falcon14141/Voron_Mods/README.md

# Voron_Mods
 Mods for my Voron 3D printers
