falcon14141/Voron_Mods/Lovely Frog Z Idler/mods/README.md

# User Mods for LFZI # 

| Mods | Authors | Description |
| ---- | --- | --- |
| [M3 screw Tensioner](./m3_screw_tensioner/) | @fboc#1751 | Replace M5 screw by M3 to reduce step per rotation, replace insert by M3 square nut. |
