falcon14141/Voron_Mods/3D Cable Chain/images/1.png

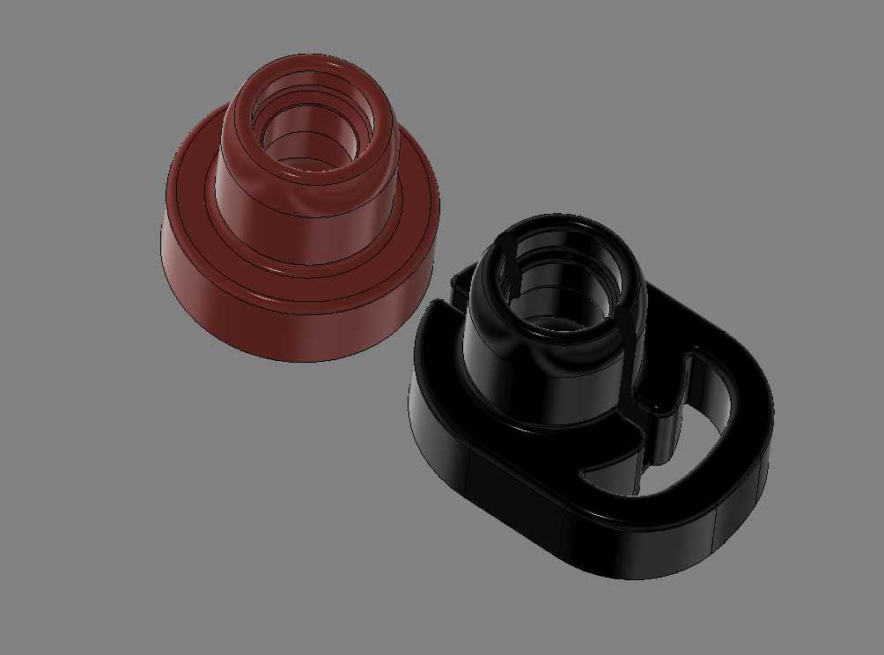
3D Cable Chain/images/1.png
