falcon14141/Voron_Mods/Dampened Fan Skirt/images/1.png

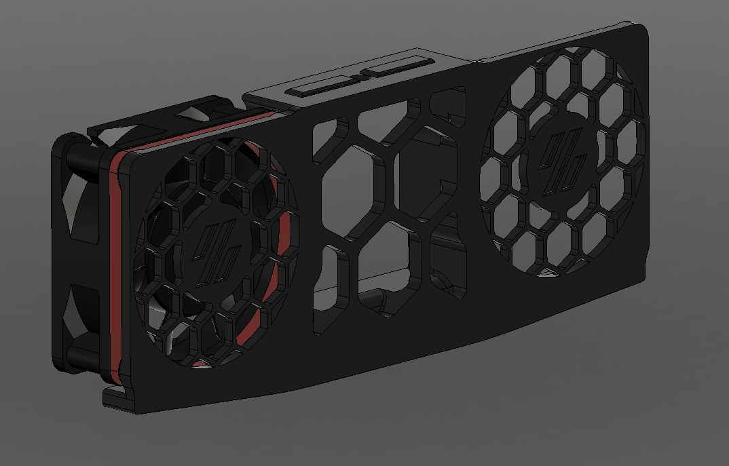
Dampened Fan Skirt/images/1.png
