falcon14141/Voron_Mods/Endstops/Y_opto_endstop/images/gantry_back.png

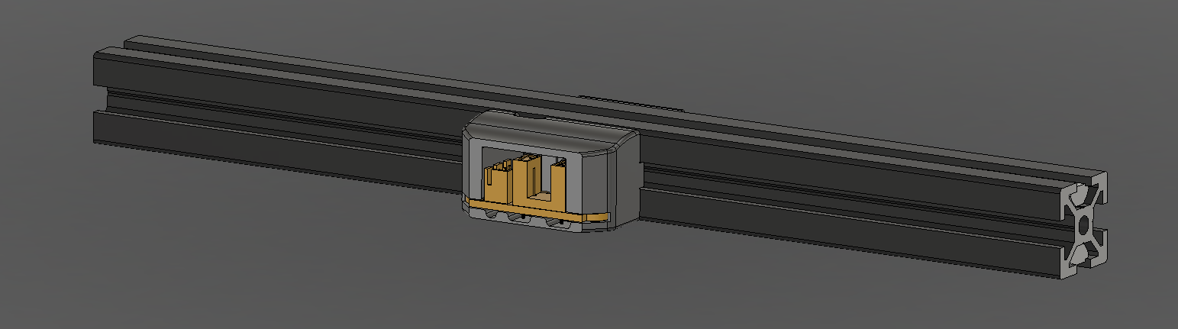
Endstops/Y_opto_endstop/images/gantry_back.png
