falcon14141/Voron_Mods/Endstops/Y_opto_endstop/images/x-axis.png

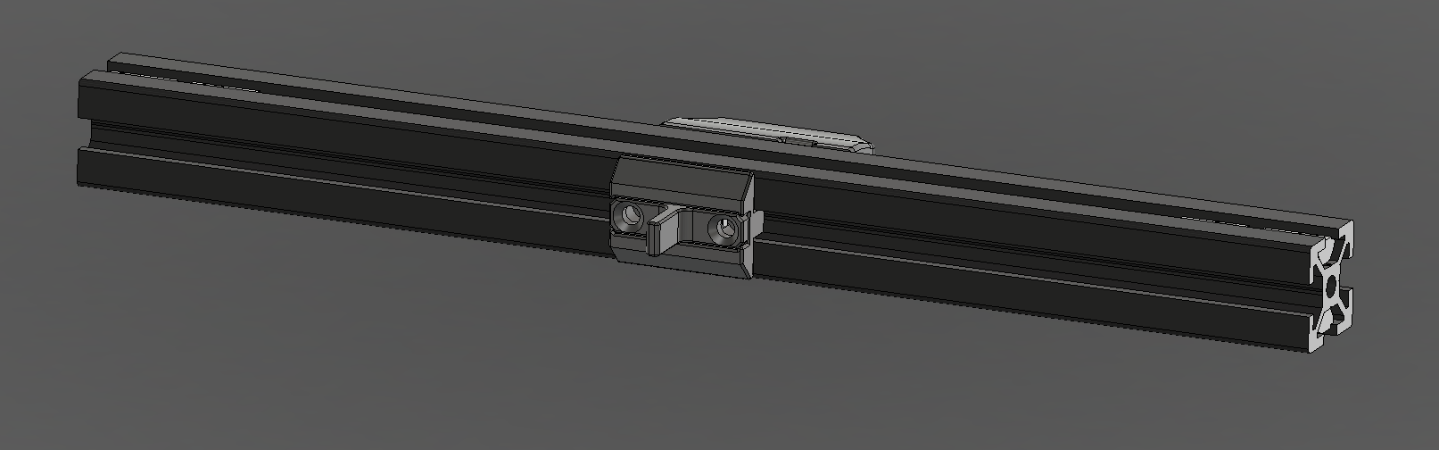
Endstops/Y_opto_endstop/images/x-axis.png
