falcon14141/Voron_Mods/Endstops/Z_Chainguard_YEndstop/images/1.png

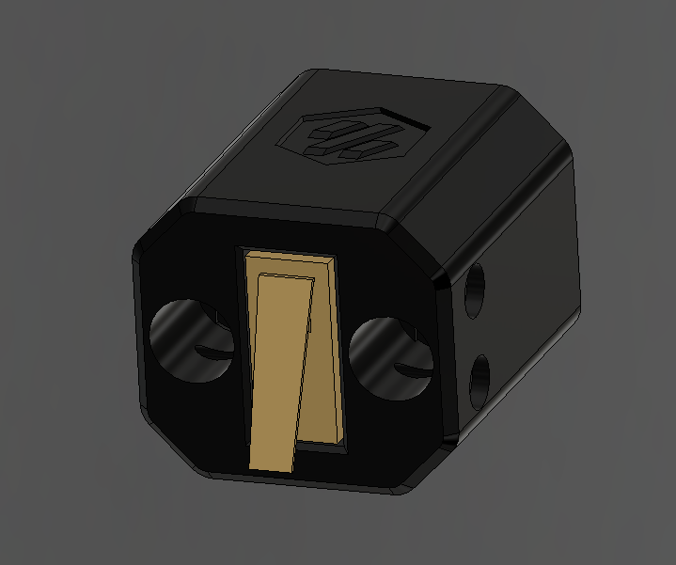
Endstops/Z_Chainguard_YEndstop/images/1.png
