falcon14141/Voron_Mods/Endstops/ZMagEndstop/images/1.png

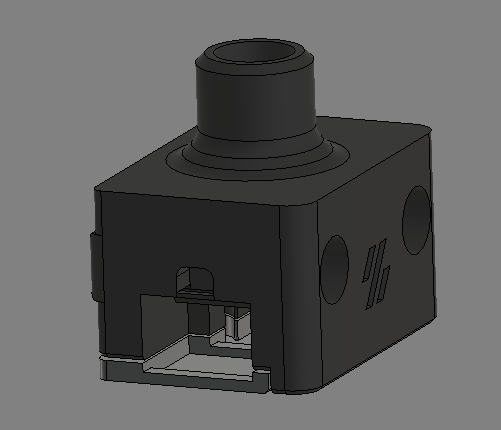
Endstops/ZMagEndstop/images/1.png
