falcon14141/Voron_Mods/Endstops/ZOptoEndstop/images/1.png

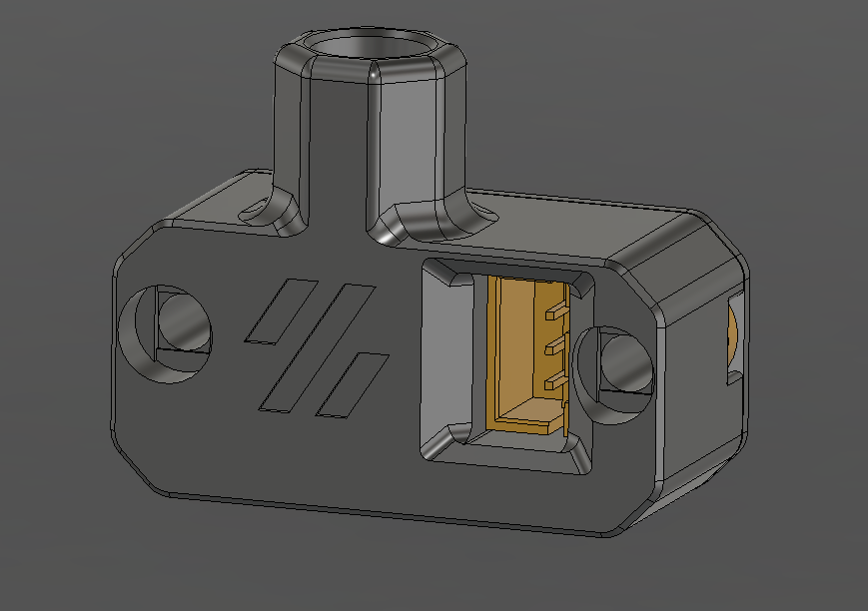
Endstops/ZOptoEndstop/images/1.png
