falcon14141/Voron_Mods/Horizontal Z chain (for CANboards)/images/1.png

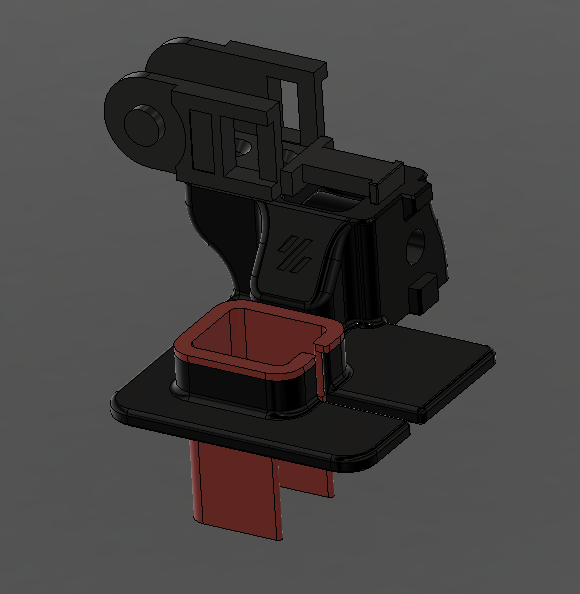
Horizontal Z chain (for CANboards)/images/1.png
