falcon14141/Voron_Mods/PiTFT 5.0 v2 hinged mount/images/2.png

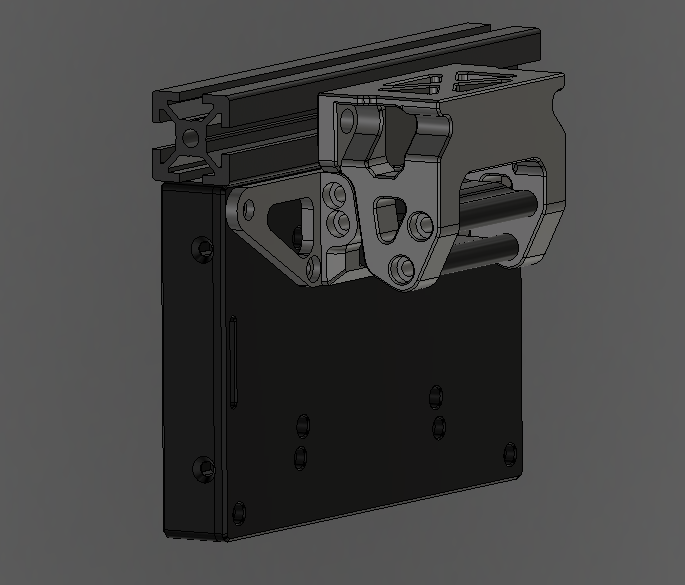
PiTFT 5.0 v2 hinged mount/images/2.png
