falcon14141/Voron_Mods/TAP Cheapzzlecam/images/CamModule.png

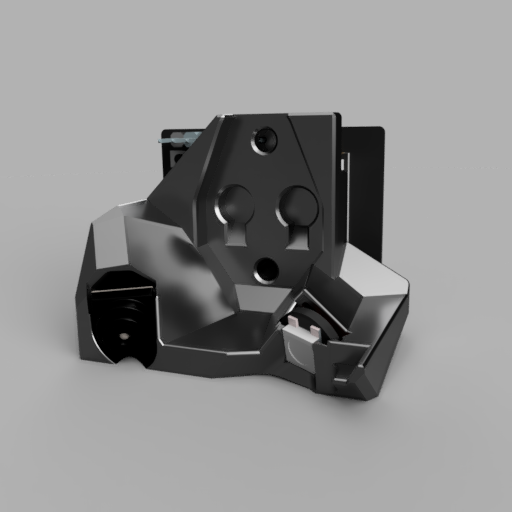
TAP Cheapzzlecam/images/CamModule.png
