falcon14141/Voron_Mods/TAP Cheapzzlecam/images/front.png

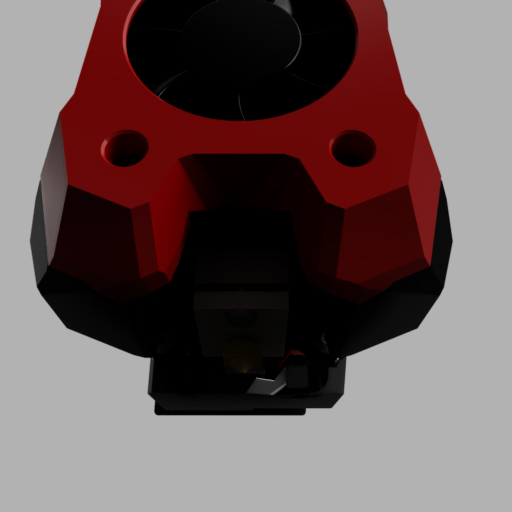
TAP Cheapzzlecam/images/front.png
