falcon14141/Voron_Mods/TAP Cheapzzlecam/images/side.png

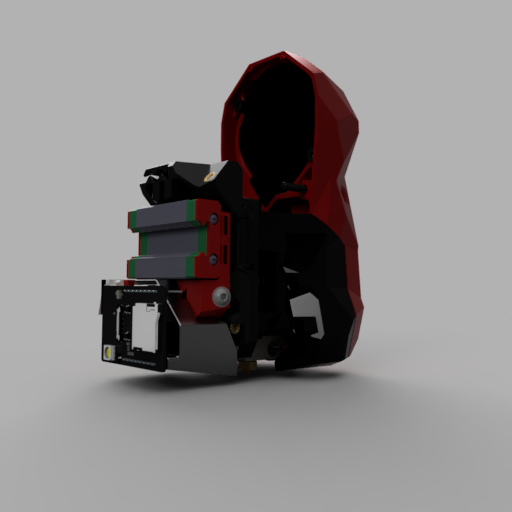
TAP Cheapzzlecam/images/side.png
