falcon14141/Voron_Mods/TAP Cheapzzlecam/images/Tap and mount.png

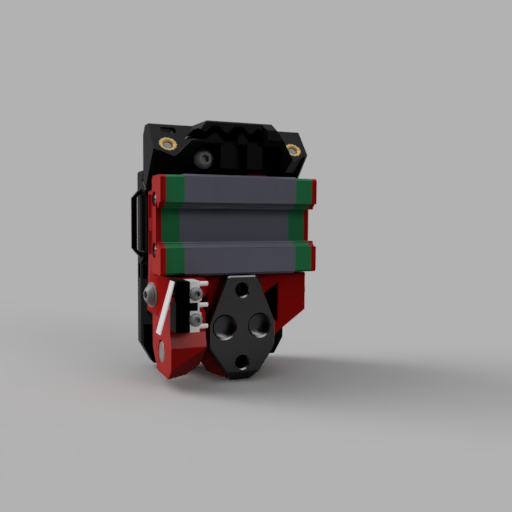
TAP Cheapzzlecam/images/Tap and mount.png
