falcon14141/Voron_Mods/3D Cable Chain/3mf/3DChain.3mf

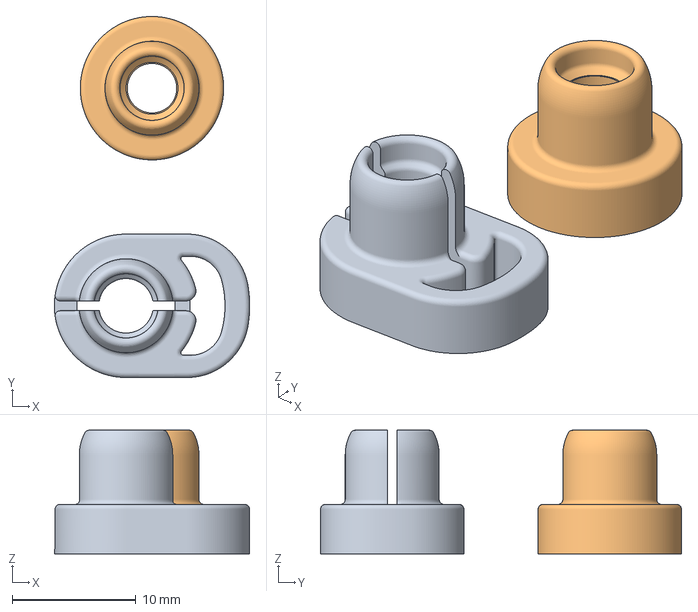
[picture p27: CAD file, 2022-07-03]
3D Cable Chain/3mf/3DChain.3mf
15.8 x 29.2 x 10.00 mm
Corps1
Corps6
