falcon14141/Voron_Mods/Dampened Fan Skirt/3mf_stl/Middle Fan Support.3mf

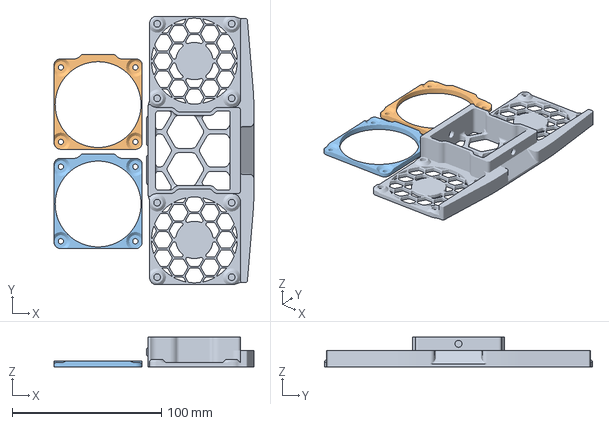
[picture p28: CAD file, 2022-07-03]
Dampened Fan Skirt/3mf_stl/Middle Fan Support.3mf
134.2 x 180.0 x 20.0 mm
side_fan_support_x2
spacer x 2
