falcon14141/Voron_Mods/Endstops/Y_opto_endstop/3mf/YOpticalEndstop.3mf

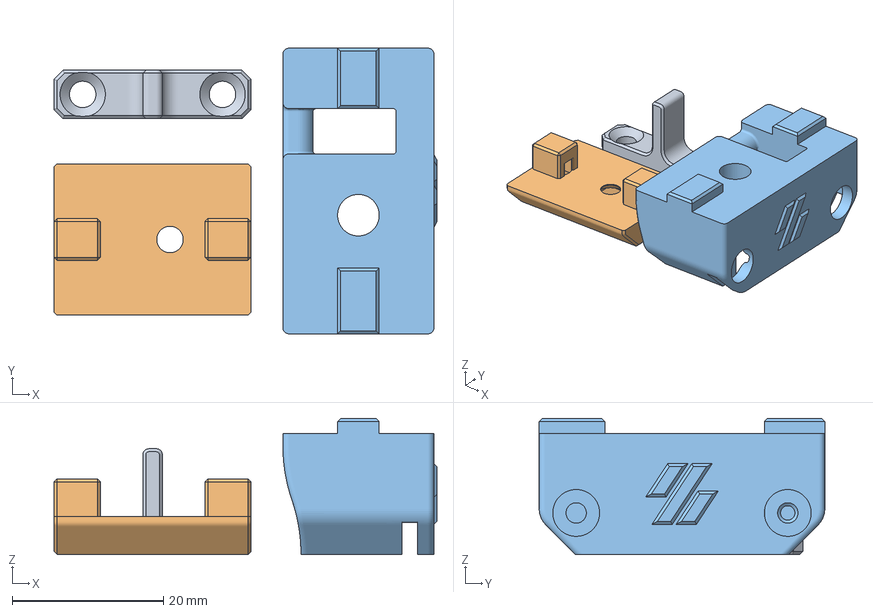
[picture p29: CAD file, 2022-07-03]
Endstops/Y_opto_endstop/3mf/YOpticalEndstop.3mf
50.7 x 37.8 x 18.0 mm
YFlag
YFlagMount
YOpticalEndstop
