falcon14141/Voron_Mods/Endstops/Z_Chainguard_YEndstop/3mf/YMechEndstopZChainGuard.3mf

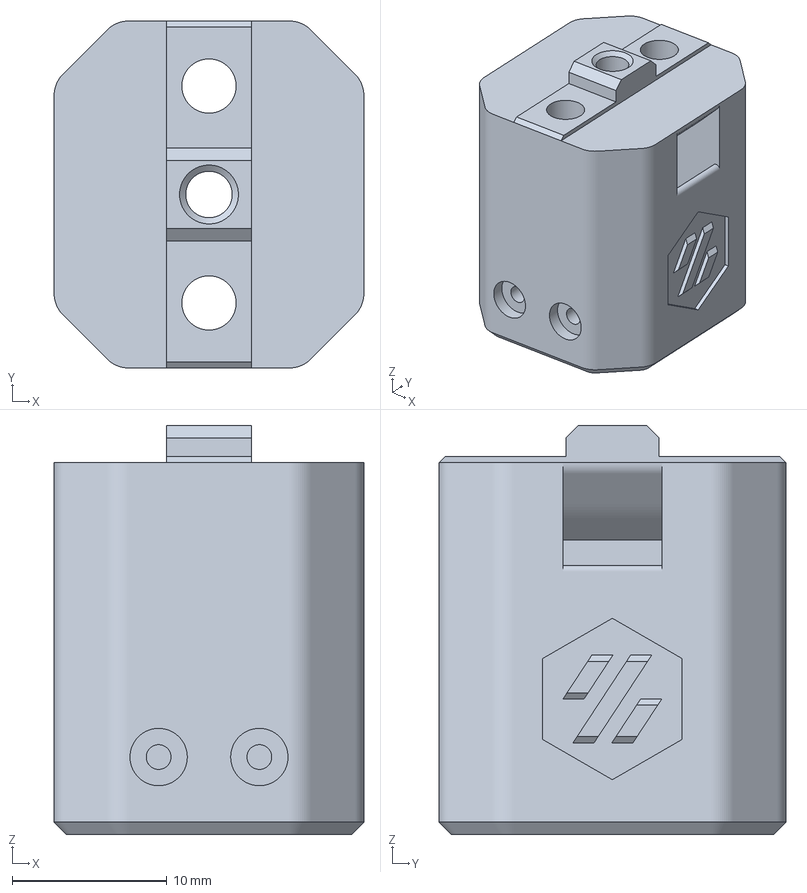
[picture p30: CAD file, 2022-07-03]
Endstops/Z_Chainguard_YEndstop/3mf/YMechEndstopZChainGuard.3mf
20.0 x 22.4 x 26.4 mm
