falcon14141/Voron_Mods/Endstops/ZMagEndstop/3mf/ZMagEndstop.3mf

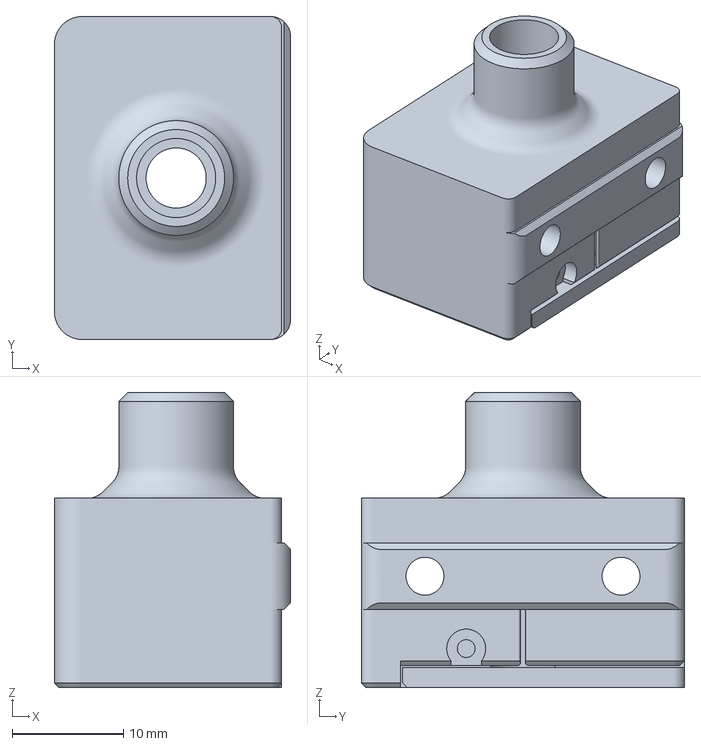
[picture p31: CAD file, 2022-07-17]
Endstops/ZMagEndstop/3mf/ZMagEndstop.3mf
21.2 x 29.0 x 26.5 mm
