falcon14141/Voron_Mods/Endstops/ZOptoEndstop/3mf/ZOpticalEndstop.3mf

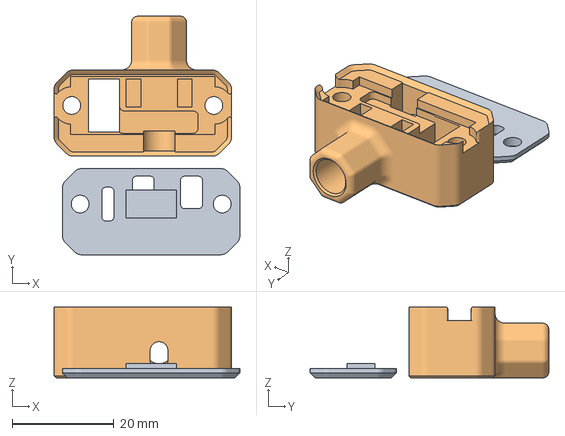
[picture p32: CAD file, 2022-07-03]
Endstops/ZOptoEndstop/3mf/ZOpticalEndstop.3mf
36.7 x 47.0 x 14.0 mm
ZOpticalEndstop_Back
ZOpticalEndstop_Front
