falcon14141/Voron_Mods/Front Purge Bucket/3mf/Bucket 250mm.3mf

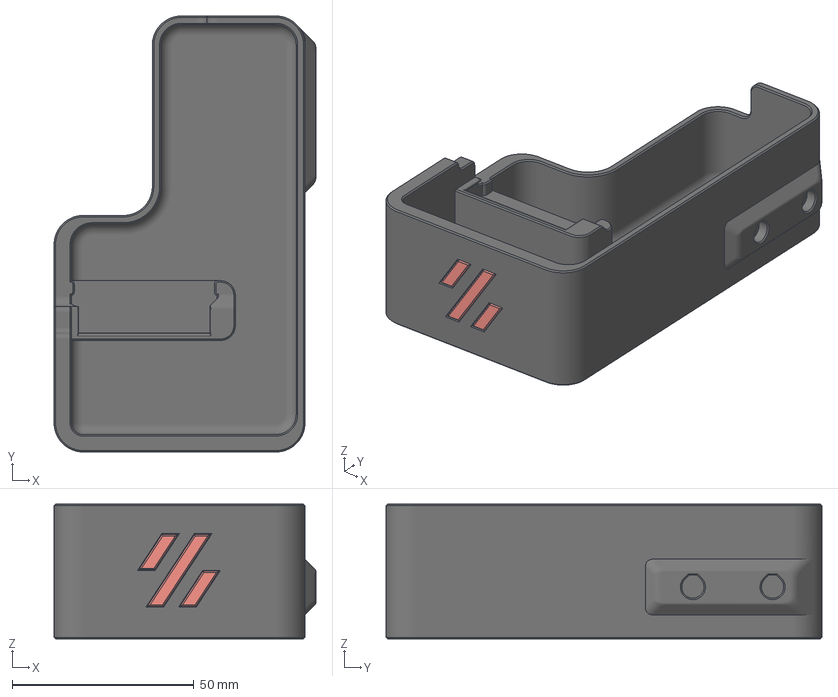
[picture p33: CAD file, 2023-01-15]
Front Purge Bucket/3mf/Bucket 250mm.3mf
72.0 x 119.8 x 37.0 mm
Bucket 250mm
Logo C
Logo L
Logo R
