falcon14141/Voron_Mods/Front Purge Bucket/CAD/Front Purge Buket 250mm.step

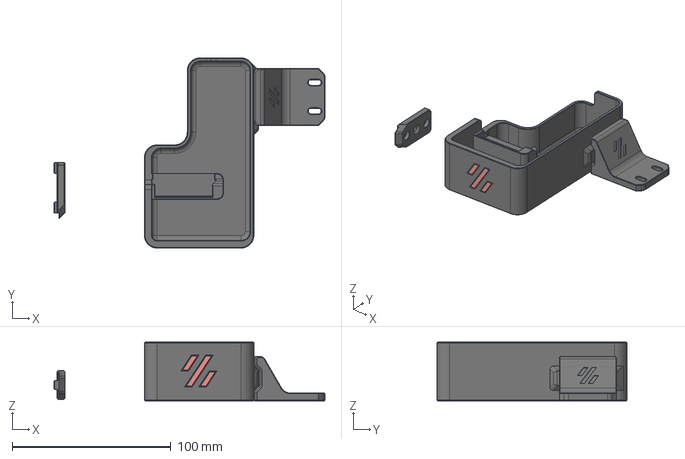
[picture p34: CAD file, 2023-01-15]
Front Purge Bucket/CAD/Front Purge Buket 250mm.step
170.8 x 119.8 x 37.0 mm
