falcon14141/Voron_Mods/Horizontal Z chain (for CANboards)/3mf/ZBeltCoverAChain Igus.3mf

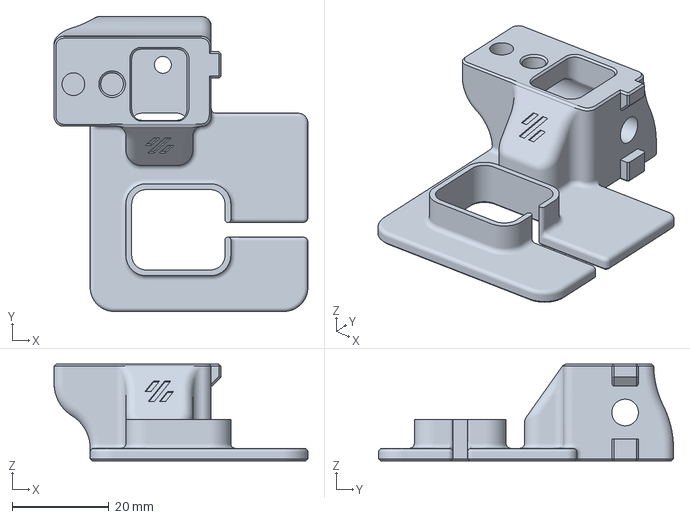
[picture p35: CAD file, 2022-07-03]
Horizontal Z chain (for CANboards)/3mf/ZBeltCoverAChain Igus.3mf
52.5 x 61.0 x 20.0 mm
