falcon14141/Voron_Mods/Lovely Frog Z Idler/3mf/mods/Lovely Frog Z Idler led cable cover.3mf

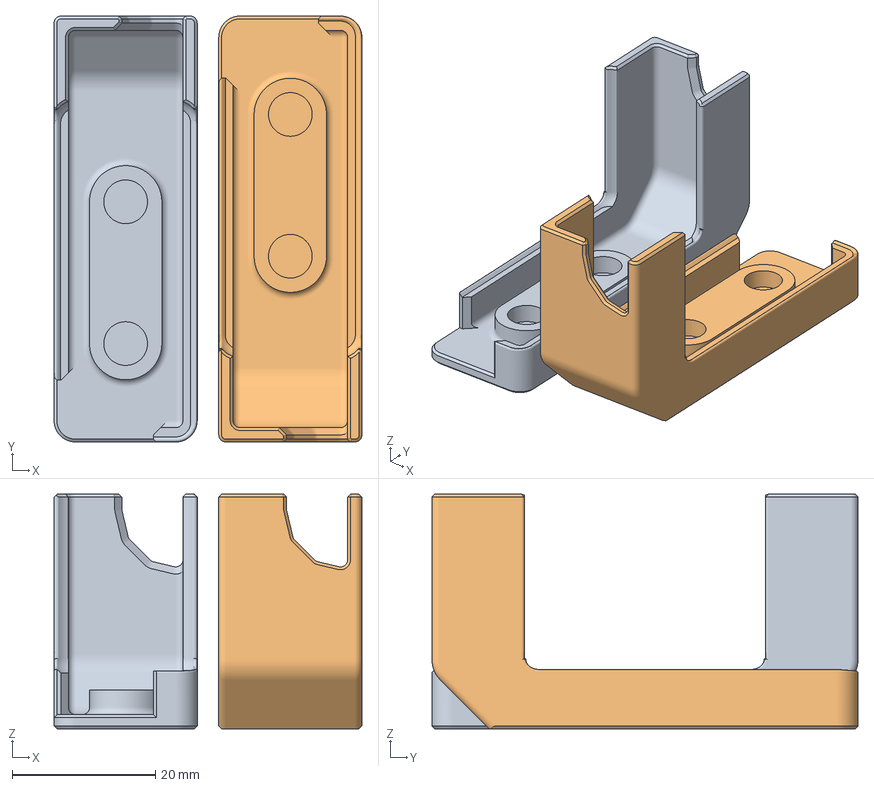
[picture p36: CAD file, 2023-01-16]
Lovely Frog Z Idler/3mf/mods/Lovely Frog Z Idler led cable cover.3mf
43.0 x 59.5 x 32.8 mm
Rear Right
Rear Left
