falcon14141/Voron_Mods/Lovely Frog Z Idler/cad/Lovely Frog Z Idler.step

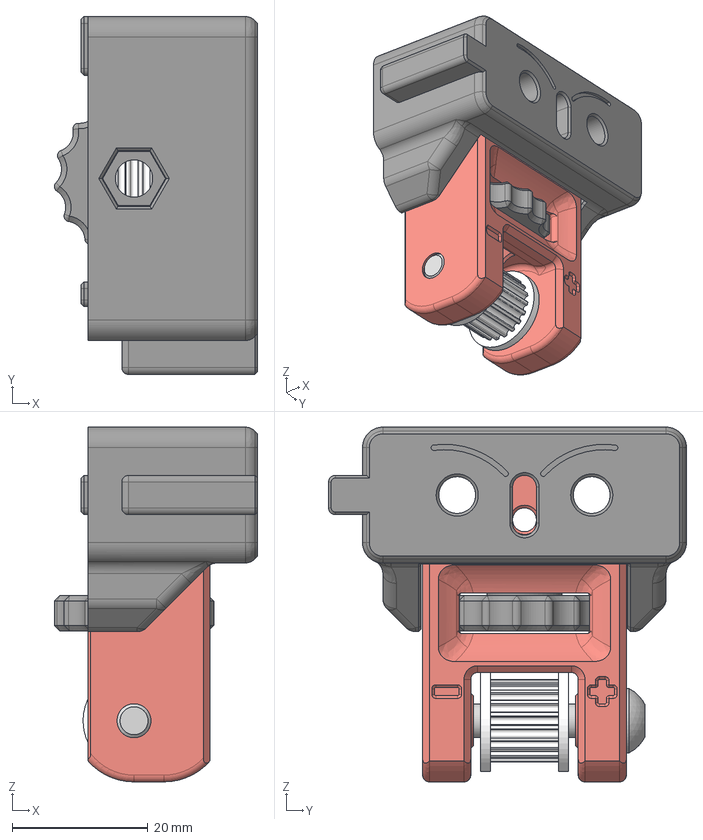
[picture p37: CAD file, 2023-01-09]
Lovely Frog Z Idler/cad/Lovely Frog Z Idler.step
29.9 x 52.7 x 52.2 mm
GT2 20T Idler Gates 9mm
M5x30 BHCS (20)
Wheel
