falcon14141/Voron_Mods/PiTFT 5.0 v2 hinged mount/3mf_stl/Front Skirt Shorter 350.stl

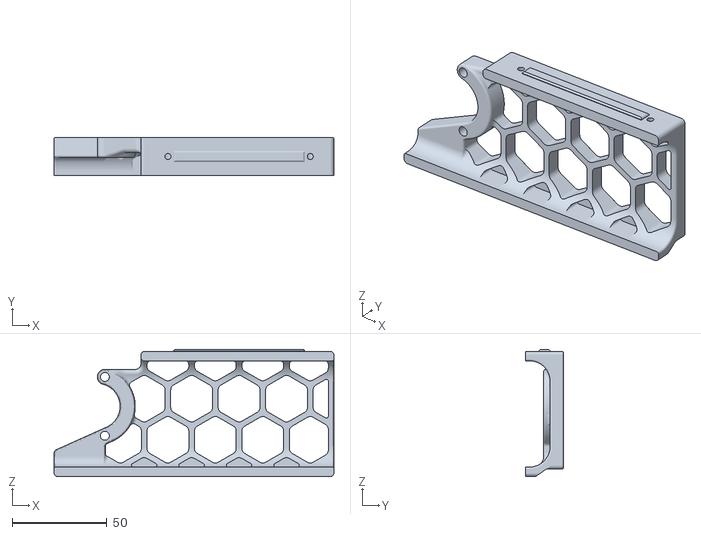
[picture p38: CAD file, 2022-07-03]
PiTFT 5.0 v2 hinged mount/3mf_stl/Front Skirt Shorter 350.stl
147.5 x 20.0 x 67.0
