falcon14141/Voron_Mods/PiTFT 5.0 v2 hinged mount/cad/shorter350mmSkirtsMotorMod.step

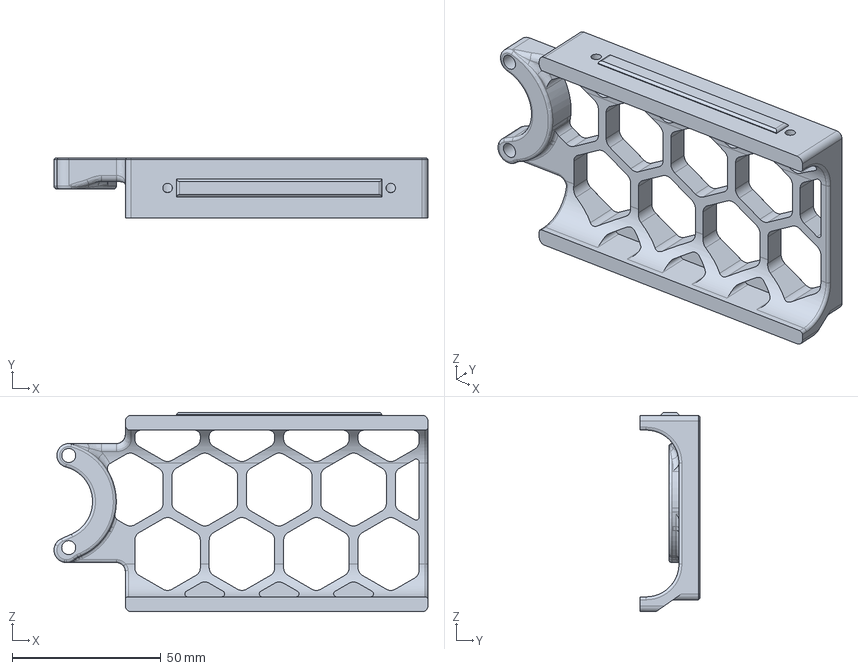
[picture p39: CAD file, 2022-07-03]
PiTFT 5.0 v2 hinged mount/cad/shorter350mmSkirtsMotorMod.step
125.7 x 20.0 x 67.0 mm
