falcon14141/Voron_Mods/Secure Magnet 270° door hinges/3mf/[a] MagneticDoorHinge.3mf

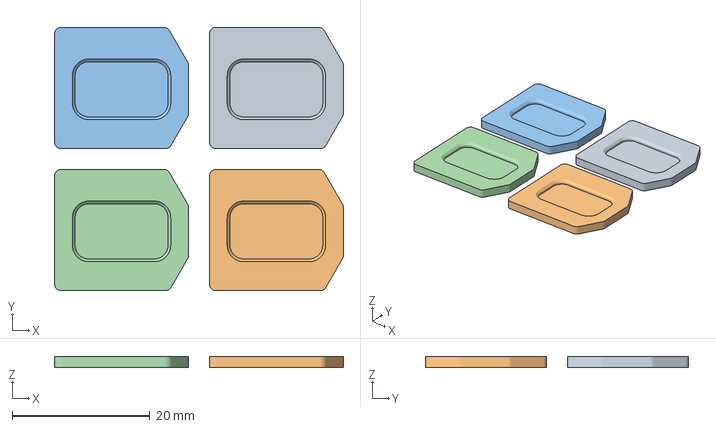
[picture p40: CAD file, 2023-01-09]
Secure Magnet 270° door hinges/3mf/[a] MagneticDoorHinge.3mf
42.0 x 38.2 x 1.60 mm
Accent_Outlet x 4
