falcon14141/Voron_Mods/Secure Magnet 270° door hinges/cad/270-Hinge-Parametric-Magnets.step

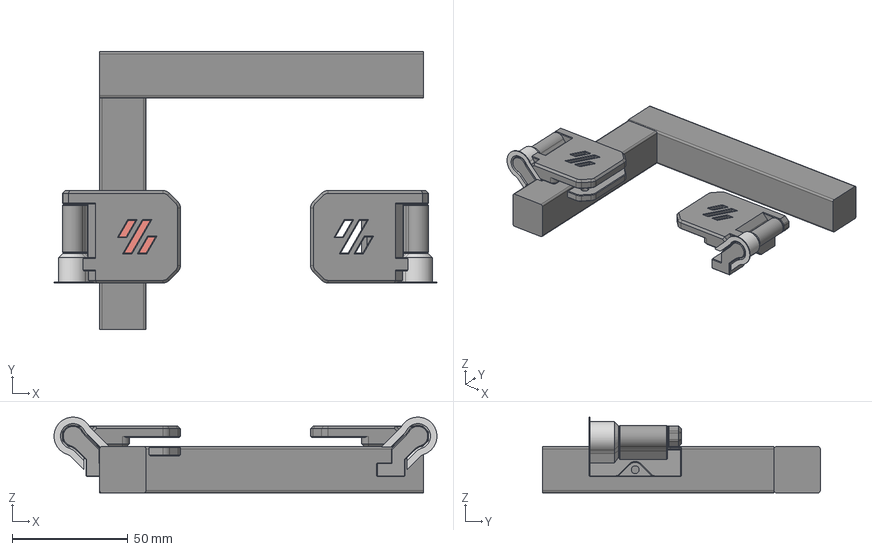
[picture p41: CAD file, 2023-01-09]
Secure Magnet 270° door hinges/cad/270-Hinge-Parametric-Magnets.step
165.5 x 120.0 x 32.7 mm
Frame
FacePlate
SideMount
BackPlate
FacePlate(Mirror)
SideMount(Mirror)
