falcon14141/Voron_Mods/Stealthburner POGO Toolhead/3mf/extruder/galileo2_ECAS_coupler.3mf

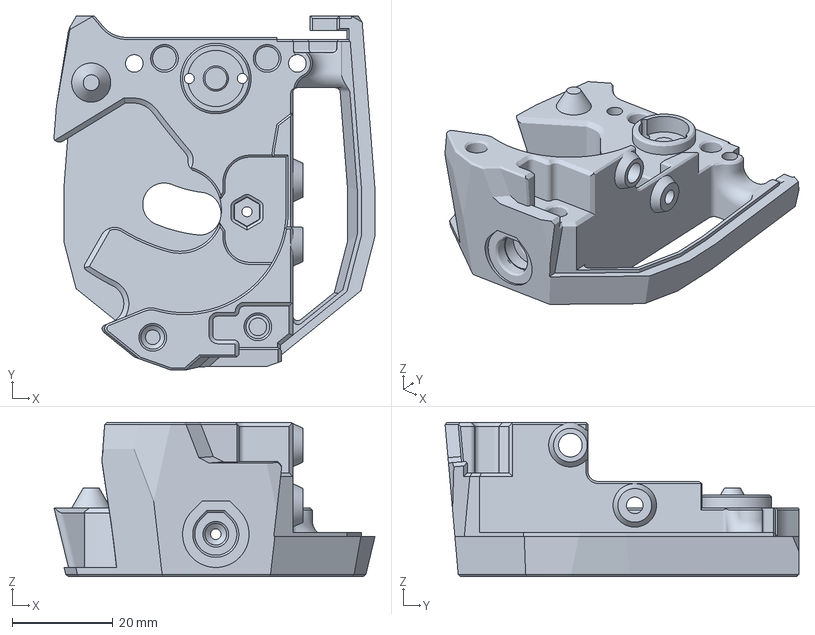
[picture p42: CAD file, 2024-07-25]
Stealthburner POGO Toolhead/3mf/extruder/galileo2_ECAS_coupler.3mf
63.8 x 70.3 x 30.6 mm
