falcon14141/Voron_Mods/Stealthburner POGO Toolhead/3mf/Toolhead Pogo soldering help.3mf

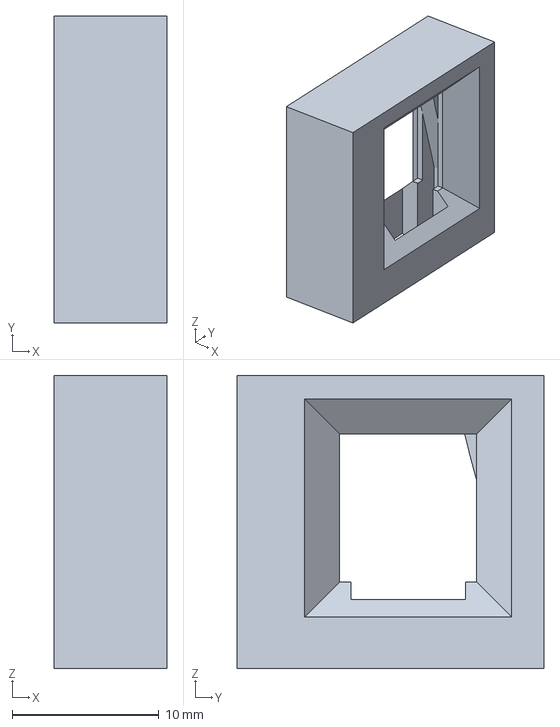
[picture p43: CAD file, 2023-01-11]
Stealthburner POGO Toolhead/3mf/Toolhead Pogo soldering help.3mf
7.68 x 20.9 x 20.0 mm
