falcon14141/Voron_Mods/Stealthburner POGO Toolhead/3mf/toolhead/Bambulab/Option A - fboc_a_SB_bambulab_TH_holder_v3_GFN.stl

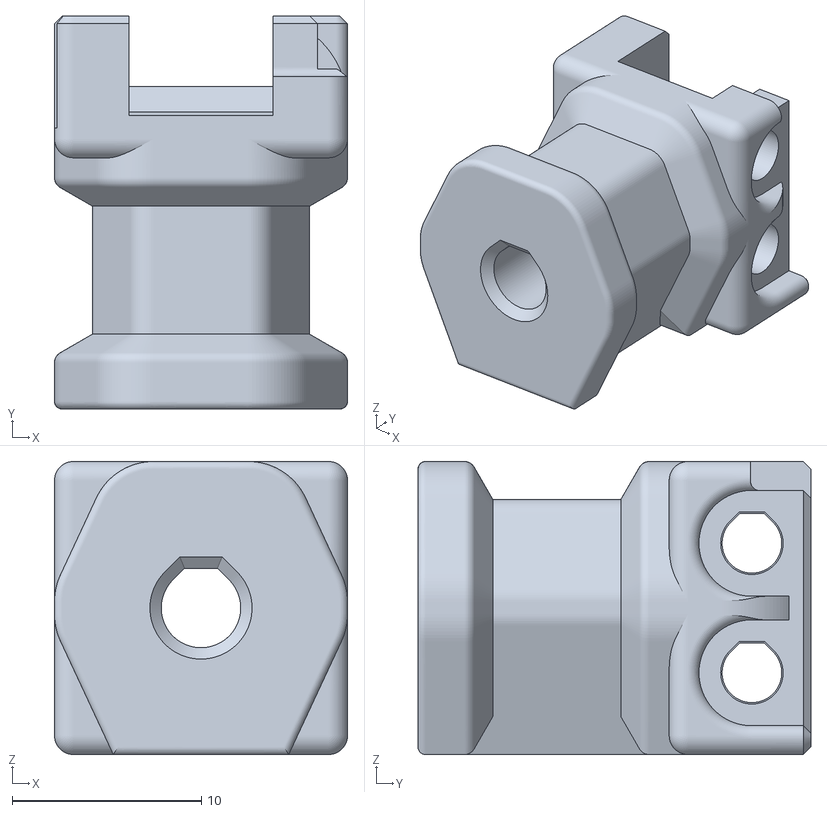
[picture p44: CAD file, 2023-01-29]
Stealthburner POGO Toolhead/3mf/toolhead/Bambulab/Option A - fboc_a_SB_bambulab_TH_holder_v3_GFN.stl
15.5 x 20.8 x 15.5
