falcon14141/Voron_Mods/Stealthburner POGO Toolhead/3mf/toolhead/BambulabAE/SB_BambulabAE_TH_rear_TN.stl

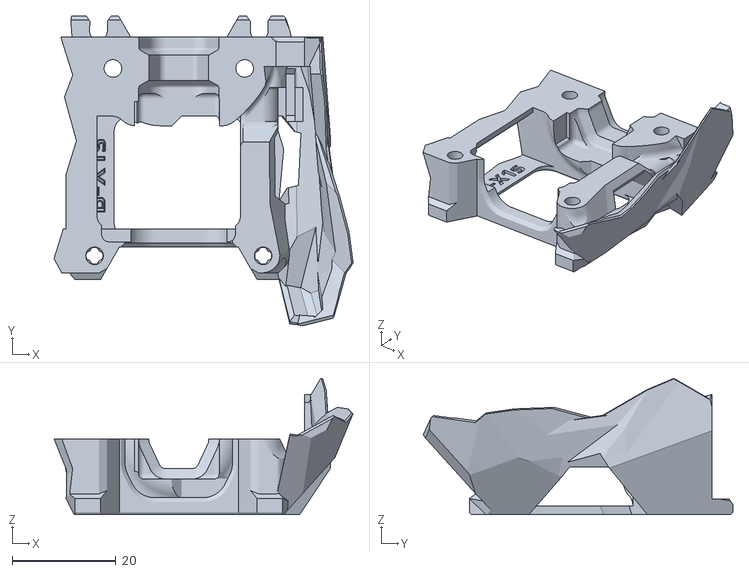
[picture p45: CAD file, 2023-05-15]
Stealthburner POGO Toolhead/3mf/toolhead/BambulabAE/SB_BambulabAE_TH_rear_TN.stl
57.7 x 59.7 x 26.3
