falcon14141/Voron_Mods/Stealthburner POGO Toolhead/3mf/toolhead/BMO/SB BMO TH Front.3mf

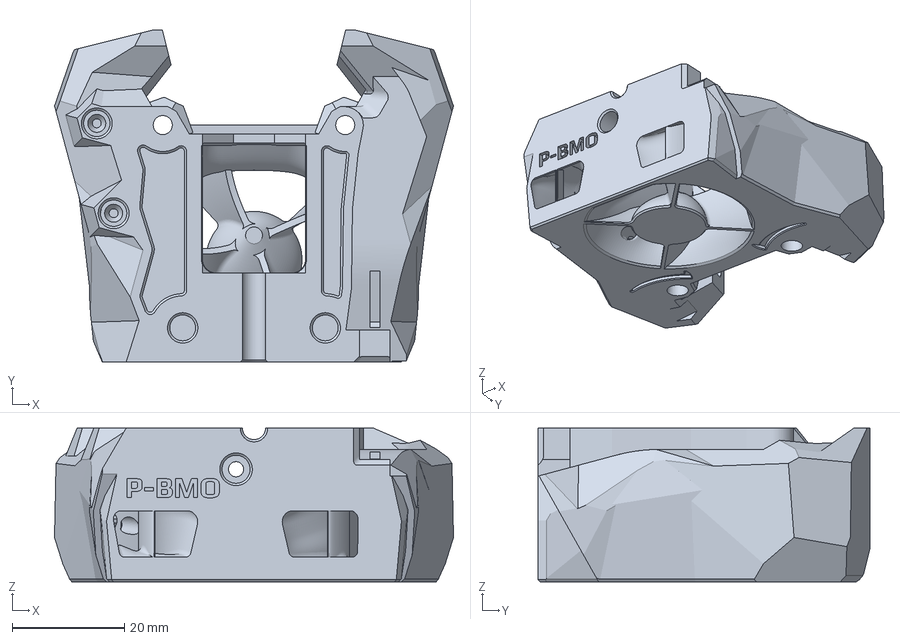
[picture p46: CAD file, 2023-01-15]
Stealthburner POGO Toolhead/3mf/toolhead/BMO/SB BMO TH Front.3mf
71.1 x 59.1 x 27.4 mm
