falcon14141/Voron_Mods/Stealthburner POGO Toolhead/3mf/toolhead/Dragon/Dragon_Front.3mf

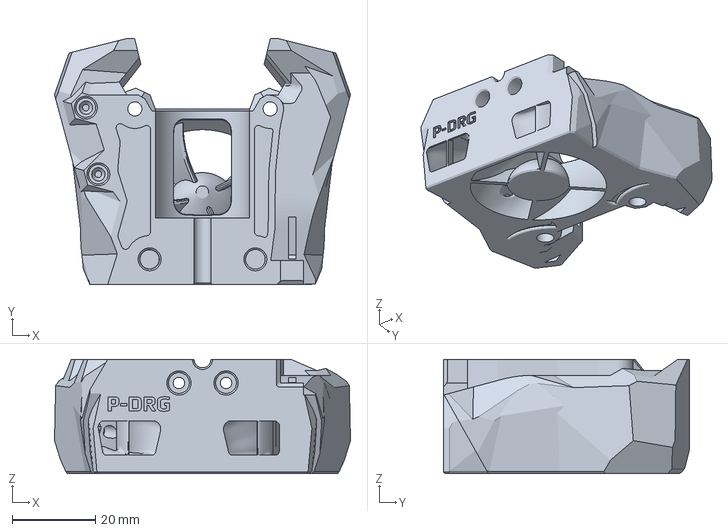
[picture p47: CAD file, 2023-01-11]
Stealthburner POGO Toolhead/3mf/toolhead/Dragon/Dragon_Front.3mf
71.1 x 59.1 x 27.4 mm
