falcon14141/Voron_Mods/Stealthburner POGO Toolhead/3mf/toolhead/Mosquito/SB MOS TH Rear.3mf

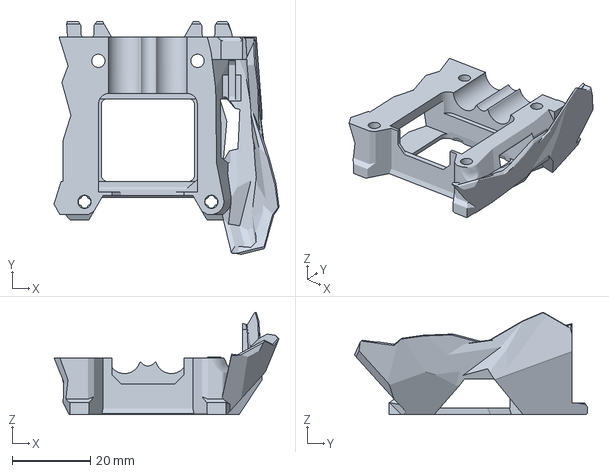
[picture p48: CAD file, 2023-01-16]
Stealthburner POGO Toolhead/3mf/toolhead/Mosquito/SB MOS TH Rear.3mf
57.7 x 59.7 x 26.3 mm
