falcon14141/Voron_Mods/Stealthburner POGO Toolhead/3mf/toolhead/Rapido/rapido-back.stl

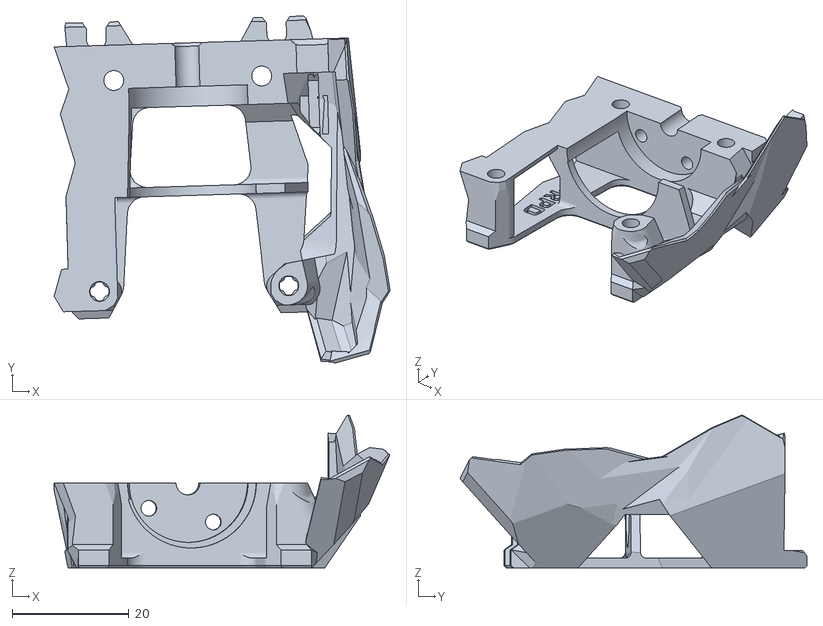
[picture p49: CAD file, 2023-01-28]
Stealthburner POGO Toolhead/3mf/toolhead/Rapido/rapido-back.stl
57.6 x 59.6 x 26.3
