falcon14141/Voron_Mods/Stealthburner POGO Toolhead/3mf/toolhead/Revo Micro/RevoMicro-Back.3mf

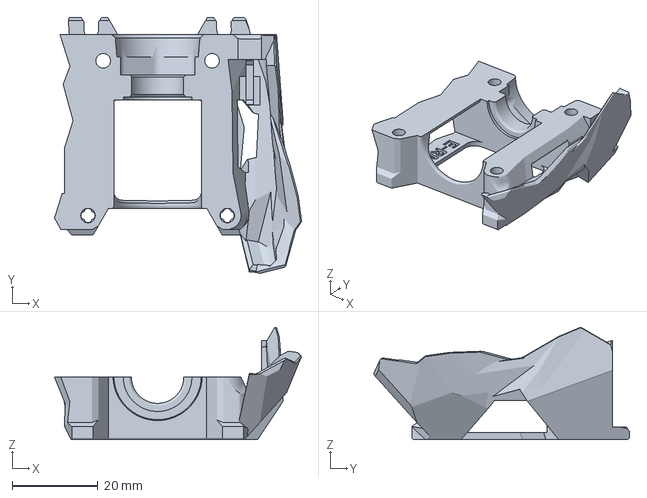
[picture p50: CAD file, 2023-01-11]
Stealthburner POGO Toolhead/3mf/toolhead/Revo Micro/RevoMicro-Back.3mf
57.7 x 59.7 x 26.3 mm
