falcon14141/Voron_Mods/TAP Cheapzzlecam/3mf/cheapzzlecam.3mf

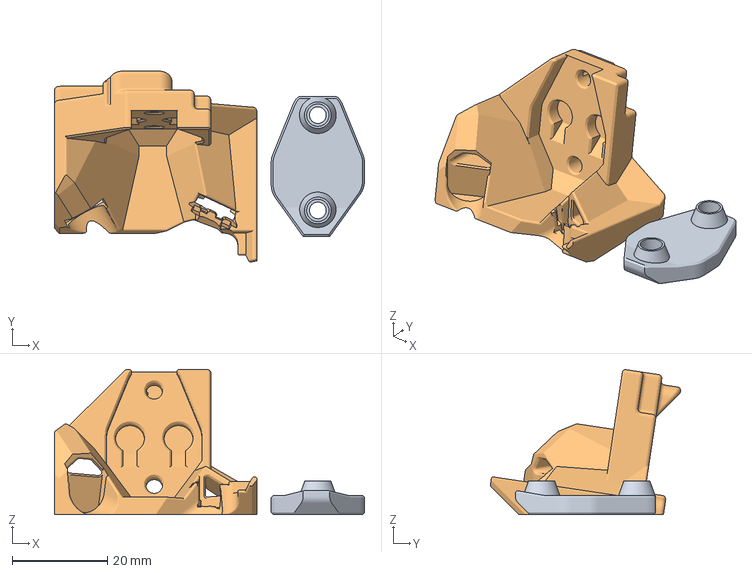
[picture p52: CAD file, 2023-02-09]
TAP Cheapzzlecam/3mf/cheapzzlecam.3mf
65.1 x 40.0 x 30.5 mm
TapModules MountBracket
tapcam
