falcon14141/Voron_Mods/Dampened Fan Skirt/3mf_stl/FanSpacer.3mf

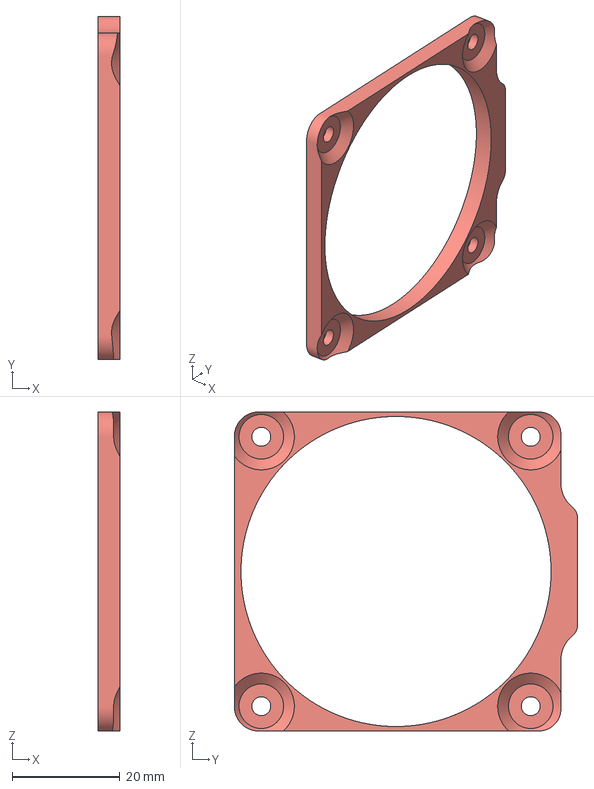
[picture p53: CAD file, 2022-07-03]
Dampened Fan Skirt/3mf_stl/FanSpacer.3mf
4.00 x 63.7 x 59.2 mm
