falcon14141/Voron_Mods/Front Purge Bucket/3mf/Brush holder.3mf

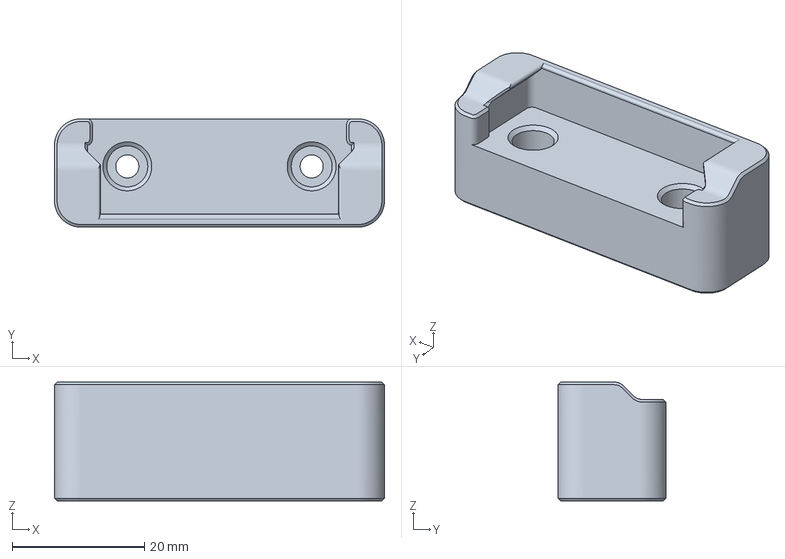
[picture p54: CAD file, 2023-01-15]
Front Purge Bucket/3mf/Brush holder.3mf
50.0 x 16.4 x 18.0 mm
