falcon14141/Voron_Mods/Front Purge Bucket/CAD/Front Purge Buket 350mm.step

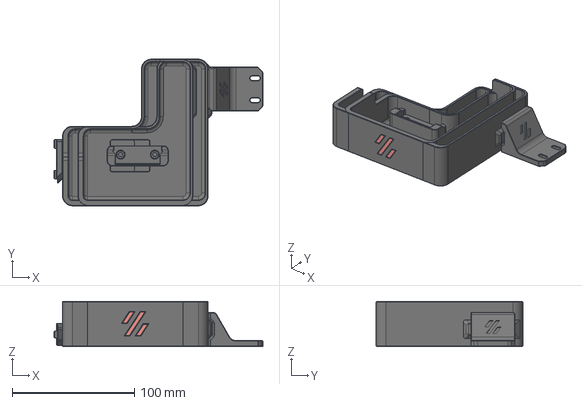
[picture p55: CAD file, 2023-01-15]
Front Purge Bucket/CAD/Front Purge Buket 350mm.step
170.8 x 119.8 x 37.0 mm
