falcon14141/Voron_Mods/Lovely Frog Z Idler/3mf/[a] Lovely Frog Z Idler pinned.3mf

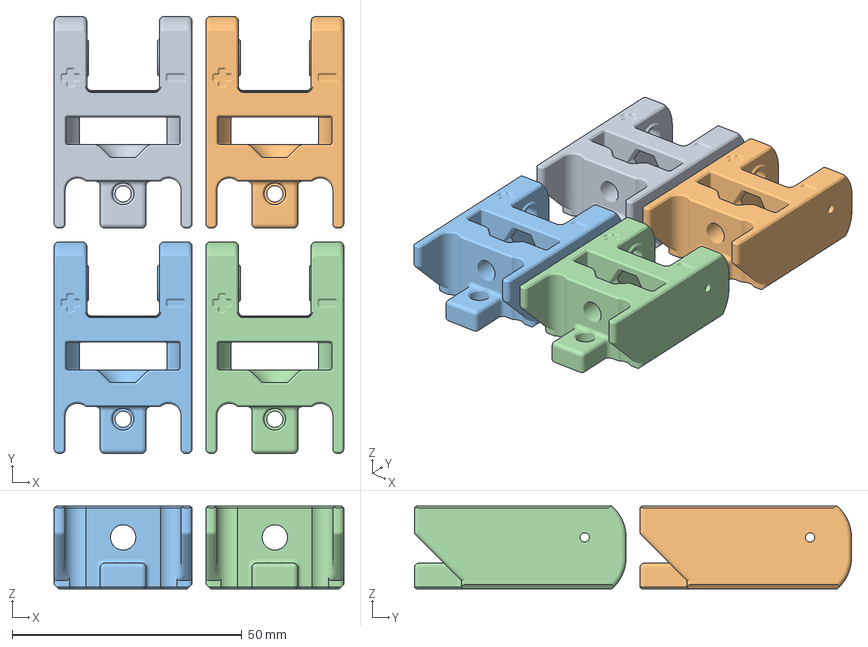
[picture p56: CAD file, 2023-01-09]
Lovely Frog Z Idler/3mf/[a] Lovely Frog Z Idler pinned.3mf
63.0 x 95.1 x 18.0 mm
Z Tensioner 9mm Pinned L x 2
Z Tensioner 9mm Pinned R x 2
