falcon14141/Voron_Mods/Secure Magnet 270° door hinges/3mf/MagneticDoorHinge-4mmPanel.3mf

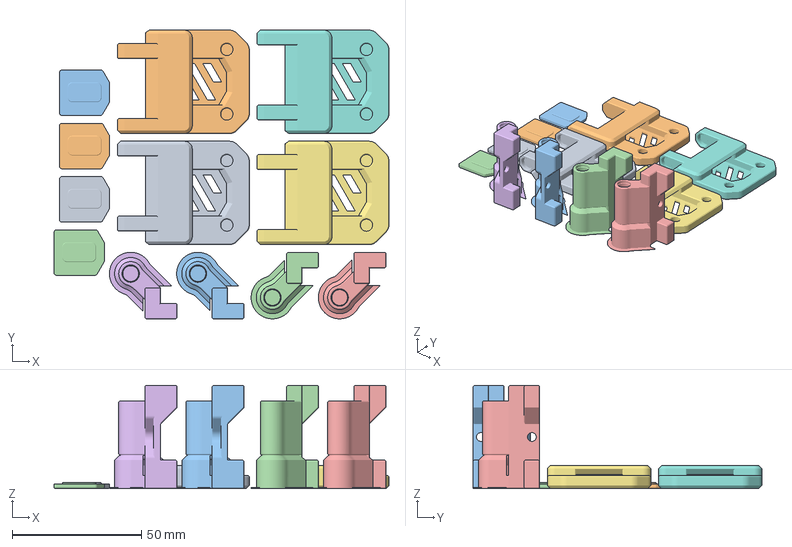
[picture p57: CAD file, 2023-01-09]
Secure Magnet 270° door hinges/3mf/MagneticDoorHinge-4mmPanel.3mf
129.7 x 111.7 x 40.0 mm
FacePlate-R x 2
FacePlate-L x 2
SideMount-R x 2
SideMount-L x 2
Accent_Inlet x 4
