falcon14141/Voron_Mods/Stealthburner POGO Toolhead/3mf/extruder/LGX_ERCF_Lite_Back.3mf

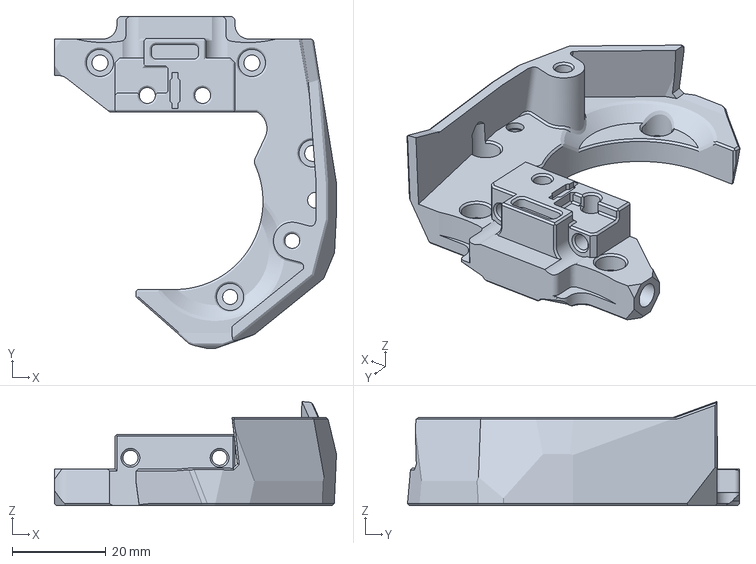
[picture p58: CAD file, 2023-05-15]
Stealthburner POGO Toolhead/3mf/extruder/LGX_ERCF_Lite_Back.3mf
60.1 x 70.8 x 22.2 mm
