falcon14141/Voron_Mods/Stealthburner POGO Toolhead/3mf/toolhead/BambulabAE/SB_BambulabAE_TH_holder.stl

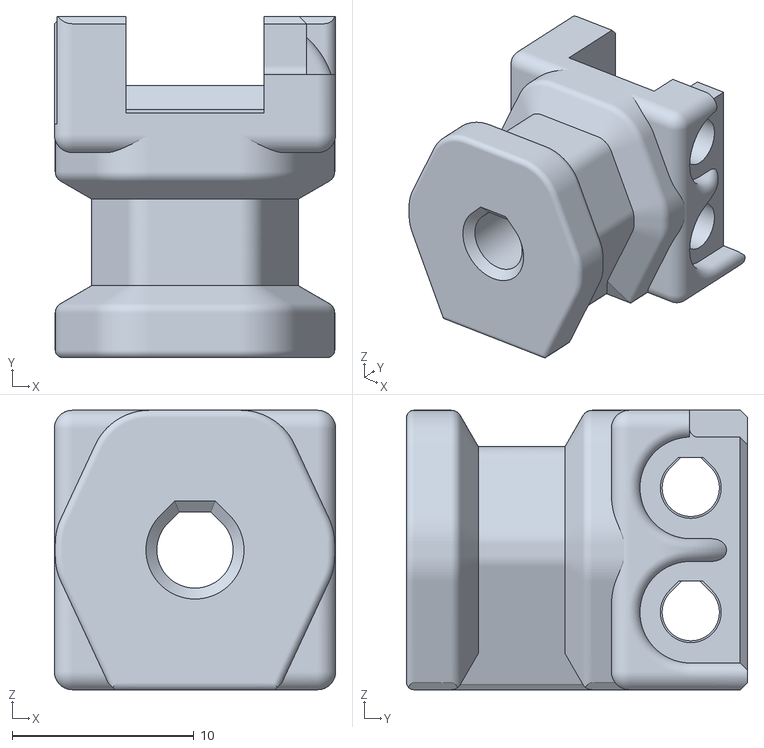
[picture p59: CAD file, 2023-05-15]
Stealthburner POGO Toolhead/3mf/toolhead/BambulabAE/SB_BambulabAE_TH_holder.stl
15.5 x 18.8 x 15.4
