falcon14141/Voron_Mods/Stealthburner POGO Toolhead/3mf/toolhead/Mosquito/SB MOS TH Front.3mf

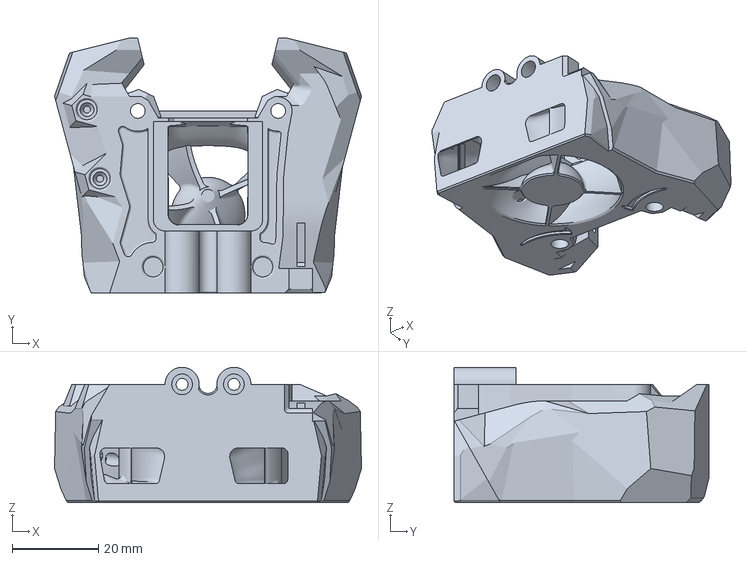
[picture p60: CAD file, 2023-01-16]
Stealthburner POGO Toolhead/3mf/toolhead/Mosquito/SB MOS TH Front.3mf
71.1 x 59.1 x 31.3 mm
