falcon14141/Voron_Mods/Front Purge Bucket/3mf/Bucket mount L.3mf

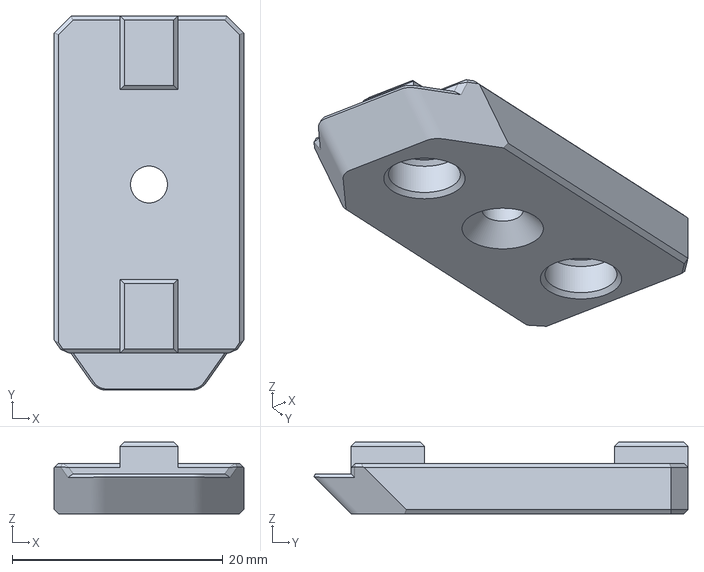
[picture p61: CAD file, 2023-01-15]
Front Purge Bucket/3mf/Bucket mount L.3mf
18.0 x 35.5 x 6.80 mm
