falcon14141/Voron_Mods/Horizontal Z chain (for CANboards)/3mf/ZBeltGuard.3mf

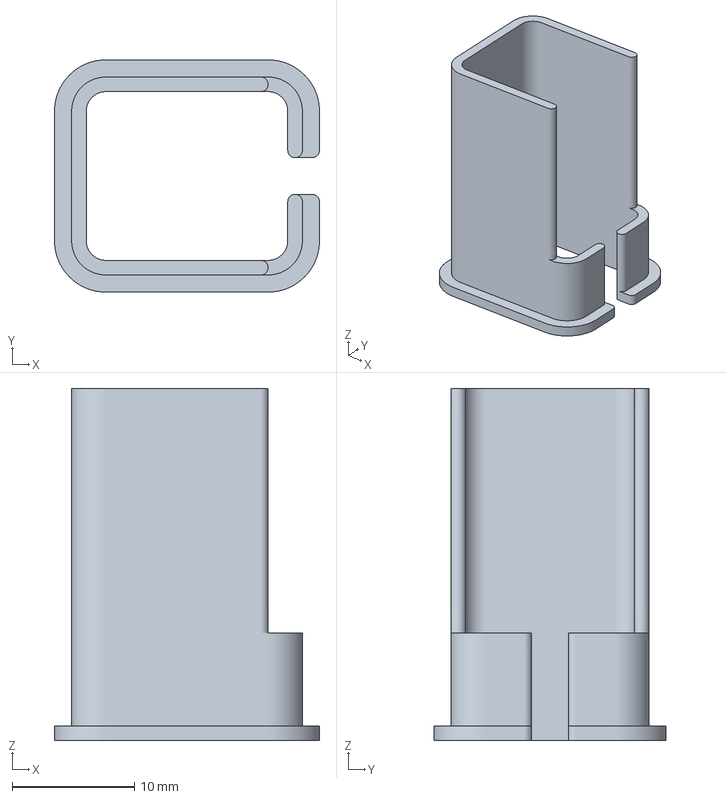
[picture p62: CAD file, 2022-07-03]
Horizontal Z chain (for CANboards)/3mf/ZBeltGuard.3mf
21.7 x 19.0 x 28.8 mm
