falcon14141/Voron_Mods/PiTFT 5.0 v2 hinged mount/3mf_stl/PiTFT5v2 Hinged Mount.3mf

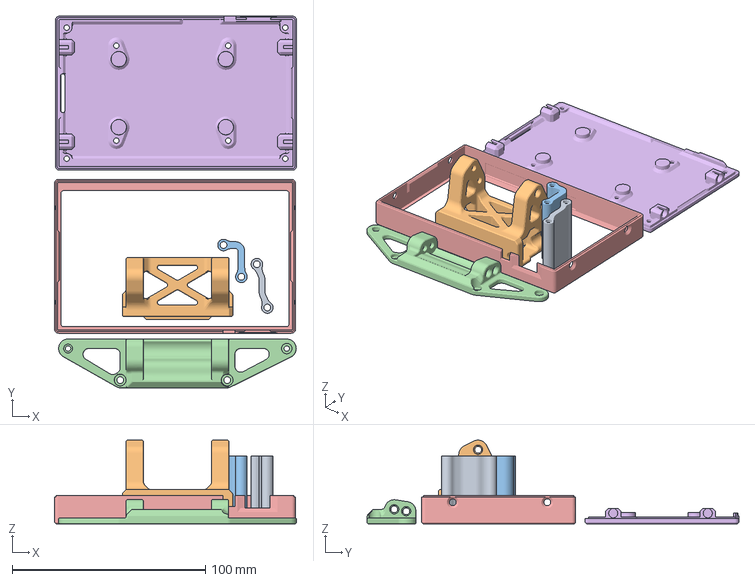
[picture p63: CAD file, 2022-07-03]
PiTFT 5.0 v2 hinged mount/3mf_stl/PiTFT5v2 Hinged Mount.3mf
125.1 x 192.1 x 43.3 mm
Corps1 x 5
Corps2
