falcon14141/Voron_Mods/Secure Magnet 270° door hinges/3mf/DoorHandleDrilled.3mf

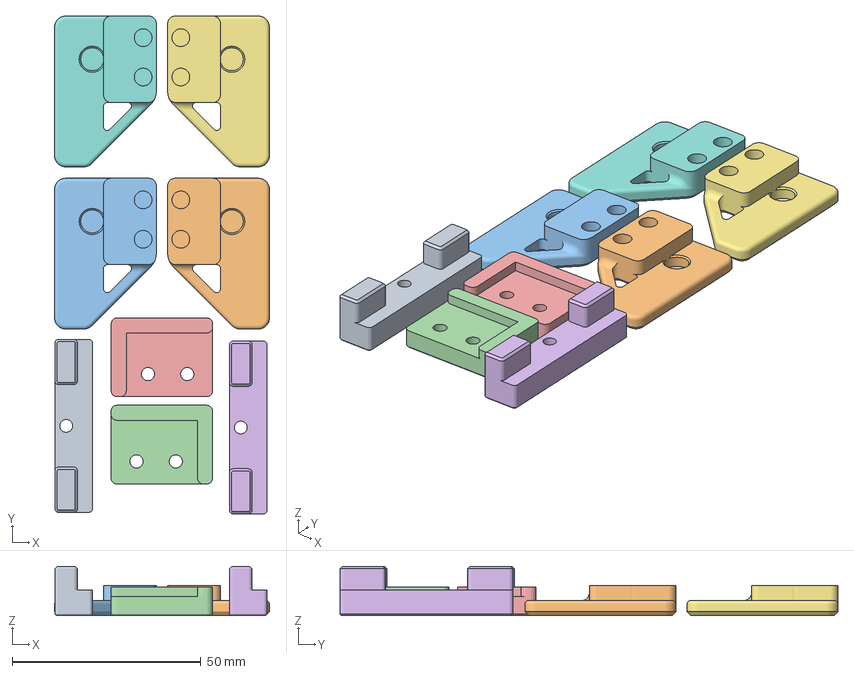
[picture p64: CAD file, 2022-07-03]
Secure Magnet 270° door hinges/3mf/DoorHandleDrilled.3mf
57.0 x 132.0 x 13.0 mm
latch_x2.stl x 2
handle_a_x2 x 2
handle_b_x2 x 2
HandleDrillGuide x 2
