falcon14141/Voron_Mods/Stealthburner POGO Toolhead/3mf/extruder/CW2_Front_ERCF.3mf

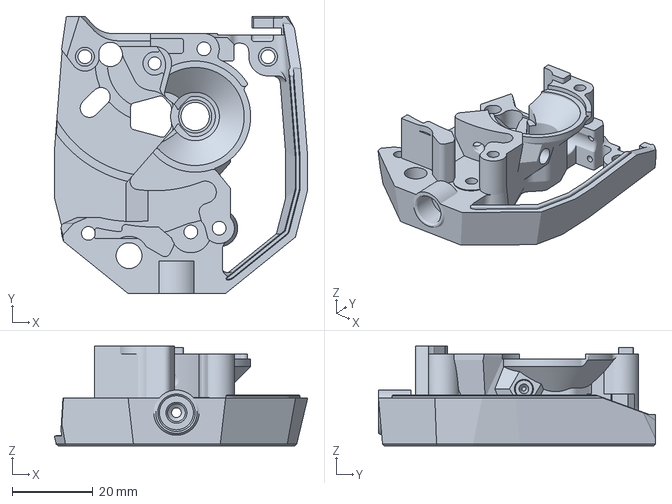
[picture p65: CAD file, 2023-01-28]
Stealthburner POGO Toolhead/3mf/extruder/CW2_Front_ERCF.3mf
62.8 x 68.7 x 24.7 mm
