falcon14141/Voron_Mods/Front Purge Bucket/3mf/Bucket 350mm.3mf

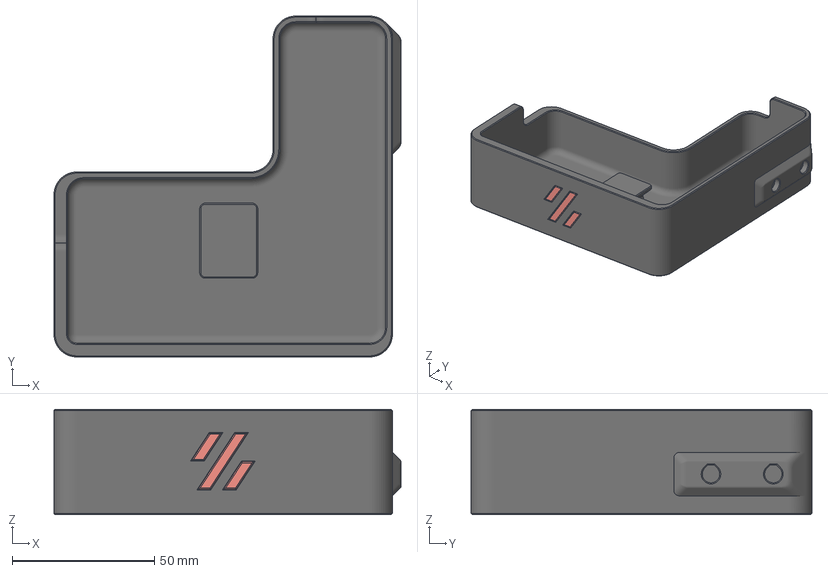
[picture p66: CAD file, 2023-01-15]
Front Purge Bucket/3mf/Bucket 350mm.3mf
122.0 x 119.8 x 37.0 mm
Bucket 350mm
Logo C
Logo L
Logo R
