falcon14141/Voron_Mods/Secure Magnet 270° door hinges/3mf/Door-DrillGuide.3mf

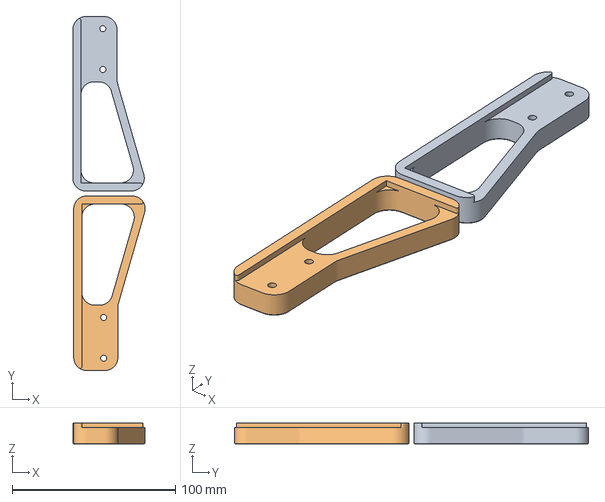
[picture p67: CAD file, 2022-07-03]
Secure Magnet 270° door hinges/3mf/Door-DrillGuide.3mf
44.3 x 217.0 x 12.6 mm
Mount-A x 2
