falcon14141/Voron_Mods/Stealthburner POGO Toolhead/3mf/extruder/LGX_ERCF_Back.3mf

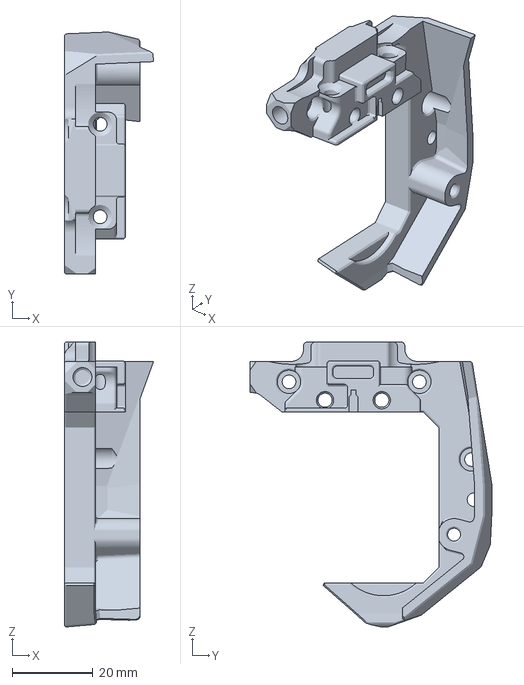
[picture p68: CAD file, 2023-01-11]
Stealthburner POGO Toolhead/3mf/extruder/LGX_ERCF_Back.3mf
22.2 x 60.1 x 70.8 mm
