falcon14141/Voron_Mods/Front Purge Bucket/3mf/Bucket mount R.3mf

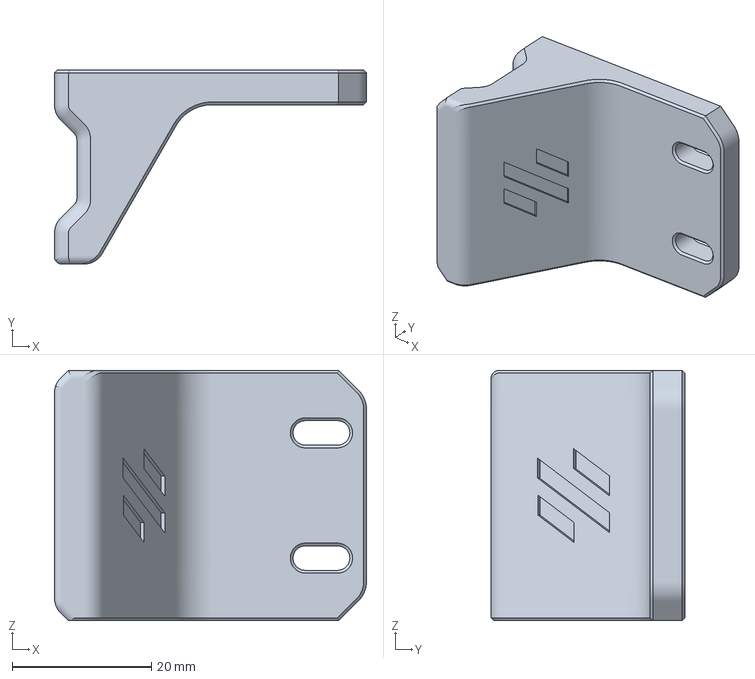
[picture p69: CAD file, 2023-01-15]
Front Purge Bucket/3mf/Bucket mount R.3mf
44.8 x 27.9 x 36.0 mm
