falcon14141/Voron_Mods/Stealthburner POGO Toolhead/3mf/extruder/LGX_ERCF_Lite_Front.3mf

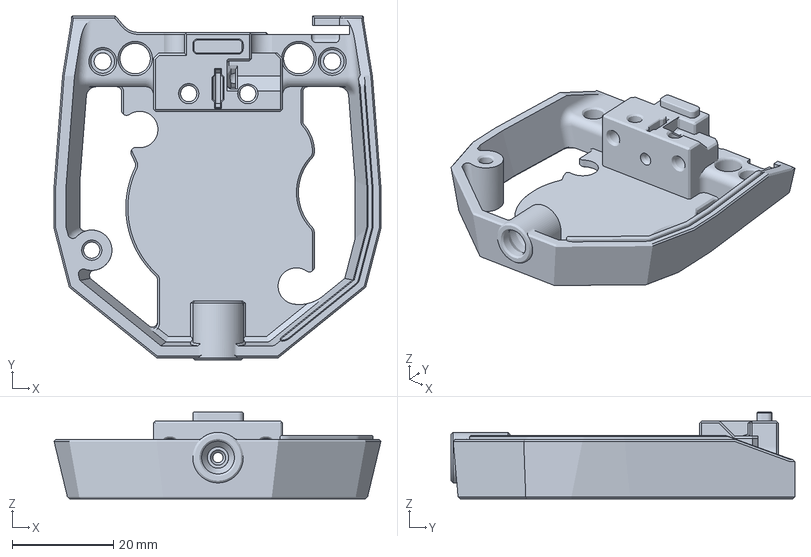
[picture p70: CAD file, 2023-01-11]
Stealthburner POGO Toolhead/3mf/extruder/LGX_ERCF_Lite_Front.3mf
64.7 x 68.1 x 17.2 mm
