falcon14141/Voron_Mods/Front Purge Bucket/3mf/Brush holder mount L.3mf

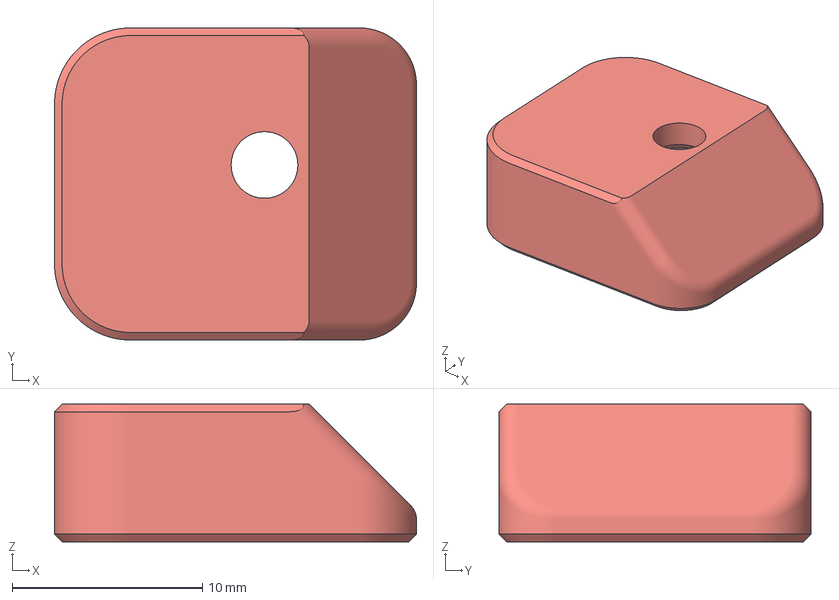
[picture p71: CAD file, 2023-01-15]
Front Purge Bucket/3mf/Brush holder mount L.3mf
19.0 x 16.4 x 7.24 mm
