falcon14141/Voron_Mods/Stealthburner POGO Toolhead/3mf/extruder/LGX_ERCF_Front.3mf

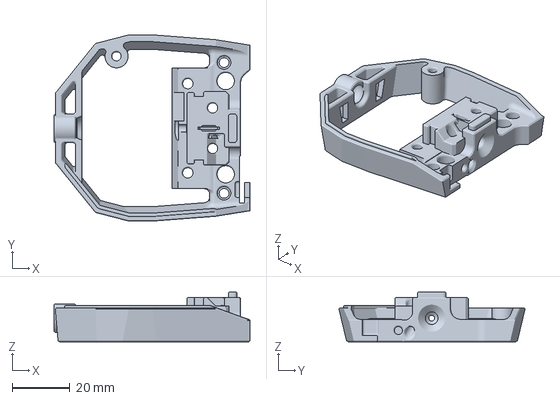
[picture p72: CAD file, 2023-01-11]
Stealthburner POGO Toolhead/3mf/extruder/LGX_ERCF_Front.3mf
68.1 x 64.7 x 17.2 mm
