falcon14141/Voron_Mods/Front Purge Bucket/3mf/Bucket 300mm.3mf

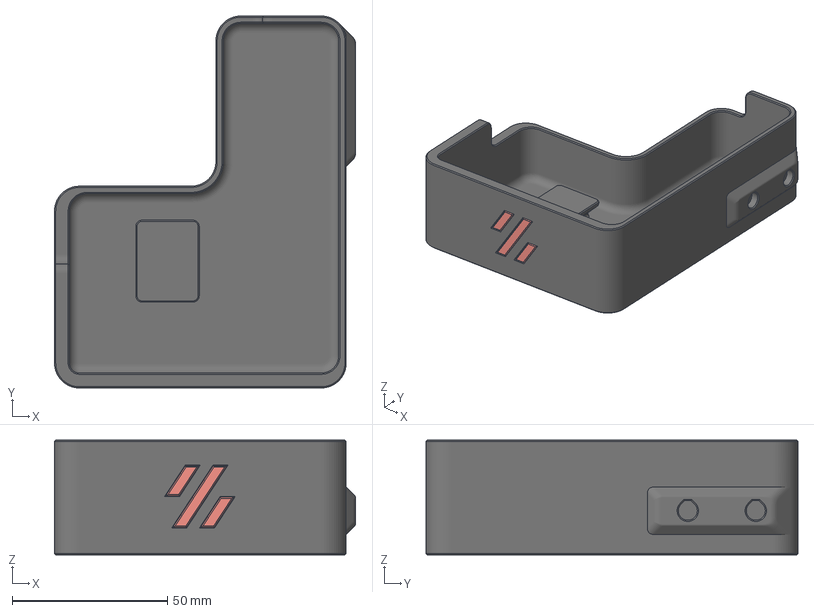
[picture p73: CAD file, 2023-01-15]
Front Purge Bucket/3mf/Bucket 300mm.3mf
97.0 x 119.8 x 37.0 mm
Bucket 300mm
Logo C
Logo L
Logo R
