falcon14141/Voron_Mods/(list of files, cad)

Other CAD files:
Horizontal Z chain (for CANboards)/3mf/ZBeltCoverAChain 3Hole.3mf
PiTFT 5.0 v2 hinged mount/3mf_stl/Front Skirt Shorter 350 ZMotor Mod.3mf
PiTFT 5.0 v2 hinged mount/cad/Shorter 350mm Skirts v3.iges
Stealthburner POGO Toolhead/3mf/toolhead/Bambulab/Option A - fboc_SB_Bambulab_TH_Rear_CW2_TN_pogo.stl
Stealthburner POGO Toolhead/3mf/toolhead/BMO/SB BMO TH Rear.3mf
Stealthburner POGO Toolhead/3mf/toolhead/Dragon/Dragon_Back.3mf
Stealthburner POGO Toolhead/3mf/toolhead/Revo Micro/RevoMicro_Front.3mf
Stealthburner POGO Toolhead/3mf/toolhead/Revo Voron/RevoVoron_Front.3mf
Dampened Fan Skirt/3mf_stl/tpu-FanSpacer.stl
Stealthburner POGO Toolhead/3mf/toolhead/Bambulab/Option B - Akboo51_Toolhead_Bambulab_rear_pogo.stl
Stealthburner POGO Toolhead/3mf/extruder/CW2_Front.3mf
Front Purge Bucket/3mf/Brush holder mount R.3mf
3D Cable Chain/cad/3DChain.f3d
Dampened Fan Skirt/3mf_stl/Middle Fan Support.stl
Endstops/ZMagEndstop/CAD/Z MagSpring Endstop.f3d
Endstops/ZOptoEndstop/cad/Z Opti Endstop.f3d
Endstops/Z_Chainguard_YEndstop/cad/YMechanicalEndstopZChainGuard.f3d
Lovely Frog Z Idler/3mf/Lovely Frog Z Idler.3mf
Lovely Frog Z Idler/3mf/[a] Lovely Frog Z Idler screw.3mf
Lovely Frog Z Idler/mods/m3_screw_tensioner/STLs/[a]_z_tensioner_x4_9mm_pinned_M3.stl
Lovely Frog Z Idler/mods/m3_screw_tensioner/STLs/wheel_M3.stl
Lovely Frog Z Idler/mods/m3_screw_tensioner/STLs/z_tensioner_bracket_a_M3_x2.stl
Lovely Frog Z Idler/mods/m3_screw_tensioner/STLs/z_tensioner_bracket_b_M3_x2.stl
Rapidly removable 270° door hinges/3mf/270HingeWithRemovableBolt.3mf
Rapidly removable 270° door hinges/3mf/[a] 270HingeWithRemovableBolt.3mf
Rapidly removable 270° door hinges/cad/270-Hinge-Parametric-ChicagoBolt.f3d
Secure Magnet 270° door hinges/cad/270-Hinge-Parametric-Magnets.f3d
