falcon14141/Voron_Mods/(commit log)

2022-07-03 ..
    ..
    [PiTFT5v2 Hinged Mount.3mf, YMechEndstopZChainGuard.3mf, YMechanicalEndstopZChainGuard.f3d, YOpticalEndstop.3mf, Z MagSpring Endstop.f3d, Z Opti Endstop.f3d, ZBeltCoverAChain 3Hole.3mf, ZBeltCoverAChain Igus.3mf]
2023-01-09 Lovely Frog Z Idler
    [270-Hinge-Parametric-Magnets.f3d, 270-Hinge-Parametric-Magnets.step, Door-DrillGuide.3mf, DoorHandleDrilled.3mf, Lovely Frog Z Idler.3mf, Lovely Frog Z Idler.step, MagneticDoorHinge-4mmPanel.3mf, [a] Lovely Frog Z Idler pinned.3mf]
2023-01-11 pogo mod
    [CW2_Front.3mf, Dragon_Back.3mf, Dragon_Front.3mf, LGX_ERCF_Back.3mf, LGX_ERCF_Front.3mf, LGX_ERCF_Lite_Back.3mf, LGX_ERCF_Lite_Front.3mf, RevoMicro-Back.3mf]
2023-01-15 Frontal Purge Bucket
    [Brush holder mount L.3mf, Brush holder mount R.3mf, Brush holder.3mf, Bucket 250mm.3mf, Bucket 300mm.3mf, Bucket 350mm.3mf, Bucket mount L.3mf, Bucket mount R.3mf]
2023-01-15 update on 250mm bucket
    [Bucket 250mm.3mf]
2023-01-15 Added BMO TH
    [SB BMO TH Front.3mf, SB BMO TH Rear.3mf]
2023-01-16 Create Lovely Frog Z Idler led cable cover.3mf
    [Lovely Frog Z Idler led cable cover.3mf]
2023-01-16 Mosquito TH
    [SB MOS TH Front.3mf, SB MOS TH Rear.3mf]
2023-01-28 pogo addons
    [CW2_Front_ERCF.3mf, rapido-back.stl]
2023-01-29 Bambulab pogo TH
    [Option A - fboc_SB_Bambulab_TH_Rear_CW2_TN_pogo.stl, Option A - fboc_a_SB_bambulab_TH_holder_v3_GFN.stl, Option B - Akboo51_Toolhead_Bambulab_rear_pogo.stl]
2023-02-15 Scrub macros
    [nozzle_scrub_adv.cfg]
2023-02-17 Create Front Purge Buket 250mm.f3d
2023-03-11 Add AE Bambulab clone TH
    [SB_BambulabAE_TH_holder.stl, SB_BambulabAE_TH_rear_TN.stl]
2023-03-11 Add M3 mod for LFZI
    [[a]_z_tensioner_x4_9mm_pinned_M3.stl, z_tensioner_bracket_a_M3_x2.stl, z_tensioner_bracket_b_M3_x2.stl]
2023-03-11 add missing M3 wheel
    [wheel_M3.stl]
2023-12-19 chore: add missing items in BOM for front purge bucket
2024-07-25 Add files via upload
    Galileo2 front body with pogomod
    [galileo2_ECAS_coupler.3mf]
